pkarcsi55/Trefort-SensorPlatform-2025/Schematic_CANSAT2026_2026-05-17.pdf

# LOLIN-Lite-ESP32 Bat+ 27 Bat- 28

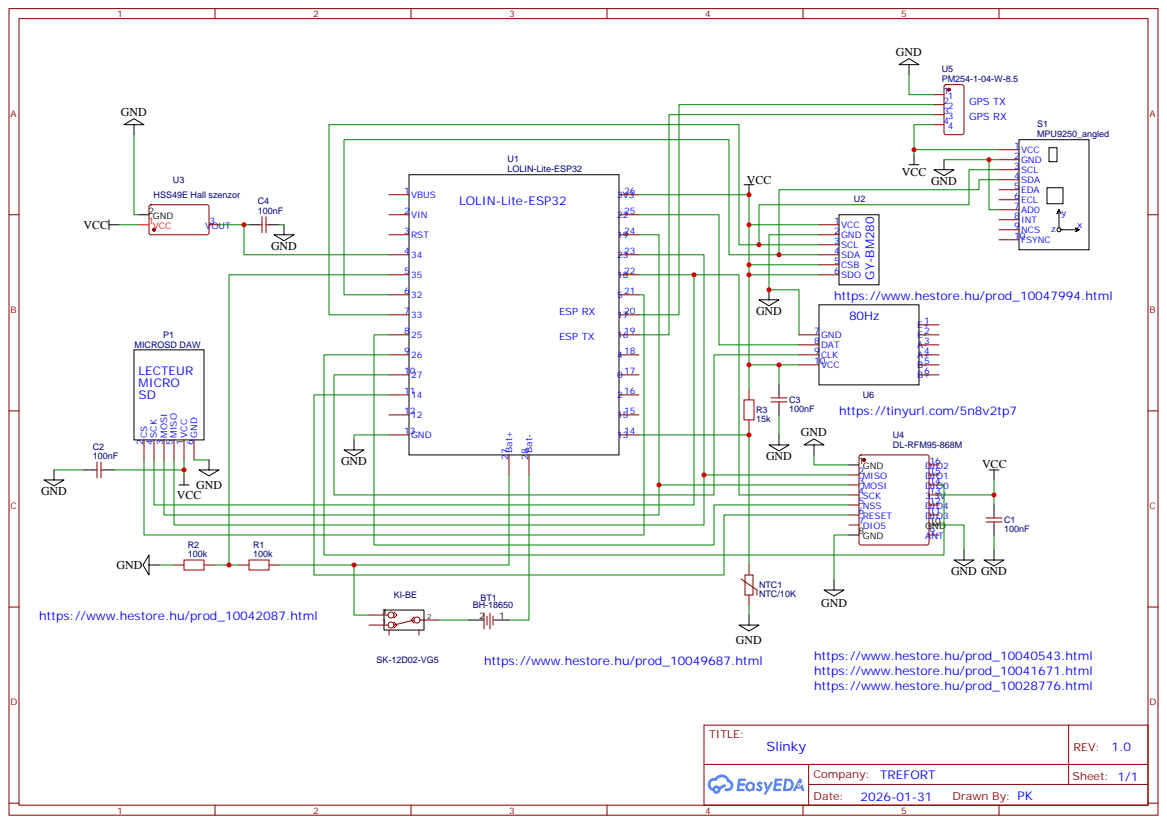
[picture p2: page 1]

https://www.hestore.hu/prod_10042087.html

https://www.hestore.hu/prod_10041671.html
https://www.hestore.hu/prod_10028776.html
