pkarcsi55/Trefort-SensorPlatform-2025/(commit log)

2025-11-16 Add files via upload
    SlinkySpace Start – több szenzoros ESP32 mérőrendszer kapcsolási rajza.
2025-11-16 Add files via upload
    SlinkySpace Start – több szenzoros ESP32 mérőrendszer kódja ESP32-re
2025-11-17 Create CanSat 2026 – ESP32 GPIO bekötési táblázat
2025-12-01 Update CanSat 2026 – ESP32 GPIO bekötési táblázat
2026-01-22 Update CanSat 2026 – ESP32 GPIO bekötési táblázat
    ---
    Ha akarod, a következő lépés lehet:
    - **README-be rövid szöveges összefoglaló**,
    - vagy egy **ASCII pin-diagram** (ESP32 felülnézet → melyik modul hova megy),
    - vagy külön **`pinout.svg` / `pinout.png`** generálása a repo-hoz.
2026-05-17 Create CANSAT 2026 – Wemos Lolin32 Lite teljes pinout.md
2026-05-17 Update CANSAT 2026 – Wemos Lolin32 Lite teljes pinout.md
